Kreyl/Locket_hw/Locket v5 BOM.xlsx

Reference | Value | Quantity | Case | PN example | Comment | URL example
B1 | BAT_HOLDER | 1 |  | provide ourselves
BLN1 | BALUN868JOHANSON | 1 |  | provide ourselves
BZ1 | PS-9627 | 1 |  | provide ourselves
C11 C12 | 18pF | 2 | 0603 | CC0603GPNPO9BN180 | any 18 pF capacitor (np0 isolator, 0603 EIA case size) no less then 6.3V
C13 C14 C15 C16 C17 C18 C19 C2 C21 C3 C4 C7 | 0.1u | 12 | 0603 | CL10B104KA8NNND | any 0.1u capacitor (x5r or x7r isolator, 0603 EIA case size) no less then 6.3V
C23 | 3.3pF | 1 | 0603 | GRM0225C1E3R3BA03L | any 3.3pF capacitor (np0 isolator, 0402 EIa Case size)
C1 C10 C20 C22 C25 C8 C9 | 10u | 7 | 0603 | CL10A106MQ8NNNC | any 10u capacitor (x5r or x7r isolator, 0603 EIA case size) no less then 6.3V
C26 | 100pF | 1 | 0402 | GRM1555C1H101JA01D | any 100 pF capacitor (np0 isolator, 0402 EIA case size) no less then 6.3V
C5 | 10n | 1 | 0603 | GCM188R72A103KA37D | any 10n capacitor (x5r or x7r isolator, 0603 EIA case size) no less then 6.3V
C6 | 1u | 1 | 0603 | CC0603KRX5R6BB105 | any 1u capacitor (x5r or x7r isolator, 0603 EIA case size) no less then 6.3V
D1 D2 | BAT54WS | 2 | SOD323 | BAT54WS |  | https://detail.1688.com/offer/40898109343.html?spm=b26110380.sw1688.mof001.10.3ca27372cg8QKP
DA1 | NCP1400 | 1 | SOT23-5 | NCP1400ASN33T1G |  | https://detail.1688.com/offer/540300246216.html?spm=b26110380.sw1688.mof001.119.632d7b28plc2Xe https://item.taobao.com/item.htm?id=19334025583&ns=1&abbucket=17
DD1 | STM32L151CxTx | 1 | LQFP48 | stm32L151c8t6-A |  | https://detail.1688.com/offer/558836849740.html?spm=b26110380.sw1688.mof001.22.19377c45TD5jn9 https://detail.1688.com/offer/573325269319.html?spm=b26110380.sw1688.mof001.79.796628faiDYZyS
DD3 | CC1101 | 1 | QFN20 | CC1101rgpr |  | https://detail.1688.com/offer/548676031389.html?spm=b26110380.sw1688.mof001.24.fae05d3eP8B6Ai
L1 | 22uH | 1 | 1210 | LQH32CN220K23L | any 22uH 150mA (or more) no more then 3mm height | https://detail.1688.com/offer/528392533919.html?spm=b26110380.sw1688.mof001.165.e9171017nwvsnq
L2 L3 | BLM15AG102SN1 | 2 | 0402 | BLM15AG102SN1 |  | https://detail.1688.com/offer/528397777745.html?spm=b26110380.sw1688.mof001.394.3e0c4cffyidIBF
L4 | 8.2nH | 1 | 0402 | LQG15HS8N2J02D | 8.2nH inductor 0402 EIA case size | https://detail.1688.com/offer/561487499843.html?spm=b26110380.sw1688.mof001.150.23c5545d32EGdF
M1 | MOTOR_NO_CONTACTS | 1 |  | provide ourselves |  | http://www.aliexpress.com/item/100pcs-lot-Model-1227-Voltage-3V-Coin-Vibration-Micro-Motor-Flat-Toy-Cell-Phone-Pager/1435504466.html
Q1 | LED_RGB 5050 | 1 |  | provide ourselves
Q2 Q3 | MMBT2222 | 2 | SOT23-3 | MMBT2222ALT1G |  | https://detail.1688.com/offer/554838664791.html?spm=b26110380.sw1688.mof001.35.6fc14c4aL9JYax
R1 R2 R3 | 100R | 3 | 0603 | RC0603FR-07100RL | any resistor 100R 0603 EIA case size 1% tolerance
R10 R11 R4 R5 | 10k | 4 | 0603 | RC0603FR-0710KL | any resistor 10k 0603 EIA case size 1% tolerance
R12 R8 | 56k | 2 | 0603 | RC0603FR-0756KL | any resistor 56k 0603 EIA case size 1% tolerance
R13 R9 | 1k | 2 | 0603 | RC0603FR-071KL | any resistor 1k 0603 EIA case size 1% tolerance
R6 | 150R | 1 | 0603 | RC0603FR-07150RL | any resistor 150R 0603 EIA case size 1% tolerance
R7 | 100k | 1 | 0603 | RC0603FR-10100KL | any resistor 100k 0603 EIA case size 1% tolerance
SW1 | DIPx8 | 1 |  | provide ourselves
SW2 SW3 SW5 | BUTTON | 3 |  | provide ourselves
SW4 | SWITCH | 1 |  | provide ourselves |  | https://s.1688.com/collaboration/collaboration_search.htm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
XL1 | CONN_6 | 1 |  | provide ourselves
XL2 | CONN_4 | 1 |  | provide ourselves
XTAL1 | 27MHz | 1 | 0532 | CX3225SB27000H0FLJCC (https://www.digikey.com/product-detail/en/kyocera-international-inc-electronic-components/CX3225SB27000H0FLJCC/1253-1754-1-ND/6123381) | any 27MHz crystal 3.2mm x 2.5mm, tolerance 10ppm | https://detail.1688.com/offer/44836150823.html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
