Kreyl/Locket_hw/Locket v.5 final 08.10.2018 China with prices.xlsx

legend | Comment | Reference | Value | Footprint | Quantity | PN example | URL example | Price (rub) | SolderPointsDIP | SolderPoints | Total SP | Sum
we have | bought 200 pcs | B1 | BAT_HOLDER | Installation:BATTERY_AAA_X2 | 1 |  |  | 5 | 2 |  | 2 | 5
manufacture | bought 200 pcs | BLN1 | BALUN868JOHANSON | Radio:BALUN_JOHANSON868 | 1 | 0896BM15A0001E | https://www.digikey.com/product-detail/en/johanson-technology-inc/0896BM15A0001E/712-1474-1-ND/2038629 | 20 |  | 6 | 6 | 20
need to buy | bought 100 pcs | BZ1 | PS-9627 | Installation:BUZZER_HC0903 | 1 | PS-9627 | http://www.buzzer-china.com/product/Magnetic-Transducer(External-Drive-Type)-PS-9627_6191.html | 5 | 2 |  | 2 | 5
need to order | any 18 pF capacitor (np0 isolator, 0603 EIA case size) no less then 6.3V | C11 C12 | 18pF | Capacitors:CAP_0603 | 2 | CC0603GPNPO9BN180 |  | 1 |  | 2 | 4 | 2
 | any 0.1u capacitor (x5r or x7r isolator, 0603 EIA case size) no less then 6.3V | C13 C14 C15 C16 C17 C18 C19 C2 C21 C3 C4 C7 | 0.1u | Capacitors:CAP_0603 | 12 | CL10B104KA8NNND |  | 1 |  |  | 0 | 12
 | any 3.3pF capacitor (np0 isolator, 0402 EIa Case size) | C23 | 3.3pF | Capacitors:CAP_0402 | 1 | GRM0225C1E3R3BA03L |  | 1 |  | 2 | 2 | 1
 | any 10u capacitor (x5r or x7r isolator, 0603 EIA case size) no less then 6.3V | C1 C10 C20 C22 C25 C8 C9 | 10u | Capacitors:CAP_0603 | 7 | CL10A106MQ8NNNC |  | 3 |  | 2 | 14 | 21
 | any 100 pF capacitor (np0 isolator, 0402 EIA case size) no less then 6.3V | C26 | 100pF | Capacitors:CAP_0402 | 1 | GRM1555C1H101JA01D |  | 1 |  | 2 | 2 | 1
 | any 10n capacitor (x5r or x7r isolator, 0603 EIA case size) no less then 6.3V | C5 | 10n | Capacitors:CAP_0603 | 1 | GCM188R72A103KA37D |  | 1 |  | 2 | 2 | 1
 | any 1u capacitor (x5r or x7r isolator, 0603 EIA case size) no less then 6.3V | C6 | 1u | Capacitors:CAP_0603 | 1 | CC0603KRX5R6BB105 |  | 3 |  | 2 | 2 | 3
 | Diode Small Signal Schottky | D1 D2 | BAT54WS | Diodes:SOD323 | 2 | BAT54WS | https://detail.1688.com/offer/40898109343.html?spm=b26110380.sw1688.mof001.10.3ca27372cg8QKP | 2 |  | 2 | 4 | 4
 | micropower step−up DC to DC converter ncp1400A | DA1 | NCP1400 | SOT:SOT23-5 | 1 | NCP1400ASN33T1G | https://detail.1688.com/offer/540300246216.html?spm=b26110380.sw1688.mof001.119.632d7b28plc2Xe https://item.taobao.com/item.htm?id=19334025583&ns=1&abbucket=17 | 10 |  |  | 0 | 10
 | microcontroller STM32L151CxTx | DD1 | STM32L151CxTx | LQFP_TQFP:LQFP48 | 1 | stm32L151c8t6 | https://detail.1688.com/offer/537609578515.html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 https://item.taobao.com/item.htm?id=558738634814&ns=1&abbucket=17 |  |  | 48 | 48 | 0
 |  |  |  |  | 1 | stm32L151c8t6-A | https://detail.1688.com/offer/558836849740.html?spm=b26110380.sw1688.mof001.22.19377c45TD5jn9 https://detail.1688.com/offer/573325269319.html?spm=b26110380.sw1688.mof001.79.796628faiDYZyS | 120 |  |  |  | 120
 |  |  |  |  |  | stm32L151cBt6-A | https://detail.1688.com/offer/575765453492.html?spm=b26110380.sw1688.mof001.19.60466f3cpN7mwc |  |  |  |  | 0
 | accelerometer | DD2 | LIS3 | LGA:LGA16_3X3_5_3 | 1 | LIS3DH | https://detail.1688.com/offer/572603039060.html?spm=b26110380.sw1688.mof001.11.6b60718f5k1w5v | 17 |  |  | 0 | 17
 | radio | DD3 | CC1101 | QFN_DFN:QFN20 | 1 | CC1101rgpr | https://detail.1688.com/offer/548676031389.html?spm=b26110380.sw1688.mof001.24.fae05d3eP8B6Ai | 60 |  | 21 | 21 | 60
 | any 22uH 150mA (or more) no more then 3mm height | L1 | 22uH | Inductors:IND_1210_LQH32C | 1 | LQH32CN220K23L | https://detail.1688.com/offer/528392533919.html?spm=b26110380.sw1688.mof001.165.e9171017nwvsnq | 5 |  |  | 0 | 5
 |  | L2 L3 | BLM15AG102SN1 | Inductors:IND_0402 | 2 | BLM15AG102SN1 | https://detail.1688.com/offer/528397777745.html?spm=b26110380.sw1688.mof001.394.3e0c4cffyidIBF | 0.3 |  |  | 0 | 0.6
 | 8.2nH inductor 0402 EIA case size | L4 | 8.2nH | Inductors:IND_0402 | 1 | LQG15HS8N2J02D | https://detail.1688.com/offer/561487499843.html?spm=b26110380.sw1688.mof001.150.23c5545d32EGdF | 0.3 |  | 2 | 2 | 0.3
 | bought 100 pcs | M1 | MOTOR_NO_CONTACTS | Installation:Motor_no_Contacts | 1 | - | http://www.aliexpress.com/item/100pcs-lot-Model-1227-Voltage-3V-Coin-Vibration-Micro-Motor-Flat-Toy-Cell-Phone-Pager/1435504466.html | 5 |  | 0 | 0 | 5
 | bought 1000 pcs | Q1 | LED_RGB 5050 | LEDs:LED_5050 | 1 | - |  | 2 |  |  | 0 | 2
 |  | Q2 Q3 | MMBT2222 | SOT:SOT23-3 | 2 | MMBT2222ALT1G | https://detail.1688.com/offer/554838664791.html?spm=b26110380.sw1688.mof001.35.6fc14c4aL9JYax | 1 |  | 3 | 6 | 2
 | any resistor 100R 0603 EIA case size 1% tolerance | R1 R2 R3 | 100R | Resistors:RES_0603 | 3 | RC0603FR-07100RL |  | 0.8 |  | 2 | 6 | 2.4
 | any resistor 10k 0603 EIA case size 1% tolerance | R10 R11 R4 R5 | 10k | Resistors:RES_0603 | 4 | RC0603FR-0710KL |  | 0.8 |  |  | 0 | 3.2
 | any resistor 56k 0603 EIA case size 1% tolerance | R12 R8 | 56k | Resistors:RES_0603 | 2 | RC0603FR-0756KL |  | 0.8 |  | 2 | 4 | 1.6
 | any resistor 1k 0603 EIA case size 1% tolerance | R13 R9 | 1k | Resistors:RES_0603 | 2 | RC0603FR-071KL |  | 0.8 |  | 2 | 4 | 1.6
 | any resistor 150R 0603 EIA case size 1% tolerance | R6 | 150R | Resistors:RES_0603 | 1 | RC0603FR-07150RL |  | 0.8 |  | 2 | 2 | 0.8
 | any resistor 100k 0603 EIA case size 1% tolerance | R7 | 100k | Resistors:RES_0603 | 1 | RC0603FR-10100KL |  | 0.8 |  | 2 | 2 | 0.8
 | bought 50 pcs, mau be need to buy 50 more | SW1 | DIPx8 | BtnsSwitches:DIP_SMD_X8 | 1 | - |  | 50 |  | 16 | 16 | 50
 | bought 200 pcs, may be need to buy more | SW2 SW3 SW5 | BUTTON | BtnsSwitches:BTN_IT1198 | 3 | - |  | 2 |  |  | 0 | 6
 | need to buy | SW4 | SWITCH | BtnsSwitches:SW_SS-1P2T_Housing | 1 | SS-1p2T | https://s.1688.com/collaboration/collaboration_search.htm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 | 1 |  |  | 0 | 1
 | need to buy | XL1 | CONN_6 | Connectors:PLS-6 | 1 | - |  | 4 | 6 |  | 6 | 4
 | need to buy | XL2 | CONN_4 | Connectors:PBS-4R | 1 | PBS-4R (DS1024-1*4R2 China PN) |  | 8 | 4 | 0 | 4 | 8
 | need to buy, need to write about concrete model any resonator 27MHZ 3.2mm x 2.5 mm size, 10 (at least 20) ppm tolerance | XTAL1 | 27MHz | Quartz:03225C4 | 1 | CX3225SB27000H0FLJCC (https://www.digikey.com/product-detail/en/kyocera-international-inc-electronic-components/CX3225SB27000H0FLJCC/1253-1754-1-ND/6123381) | https://detail.1688.com/offer/44836150823.html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 | 4 |  | 4 | 4 | 4
 |  | PCB (из рассчета 100 шт) |  |  |  |  |  |  |  |  |  | 80
 |  |  |  |  |  |  |  |  |  |  |  | 460.3
