Kreyl/Locket_hw/Case/LocketTopStar.STL

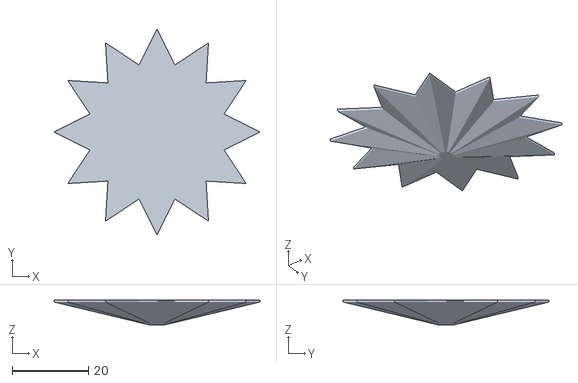
[picture p1: CAD file, 2016-01-13]
Case/LocketTopStar.STL
54.0 x 54.0 x 6.50
