Kreyl/Locket_hw/PCB/LocketEdgeCuts.DXF

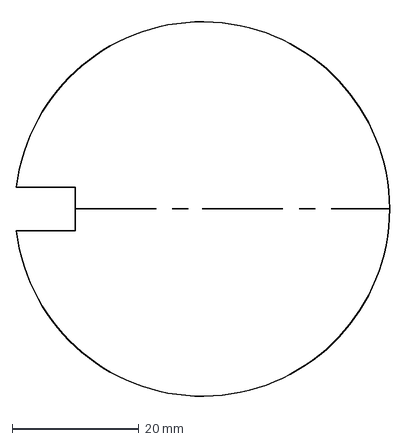
[picture p2: CAD file, 2016-01-20]
PCB/LocketEdgeCuts.DXF
58.8 x 60.7 mm
