Kreyl/Locket_hw/Case/LocketCase02.STL

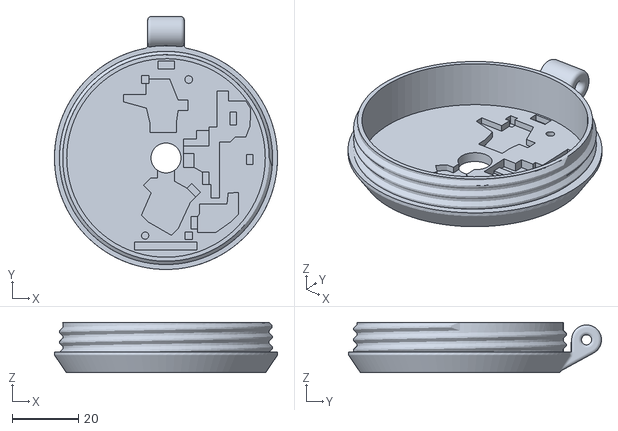
[picture p3: CAD file, 2016-01-13]
Case/LocketCase02.STL
67.2 x 76.2 x 15.2
