Kreyl/Locket_hw/Case/LocketCover.STL

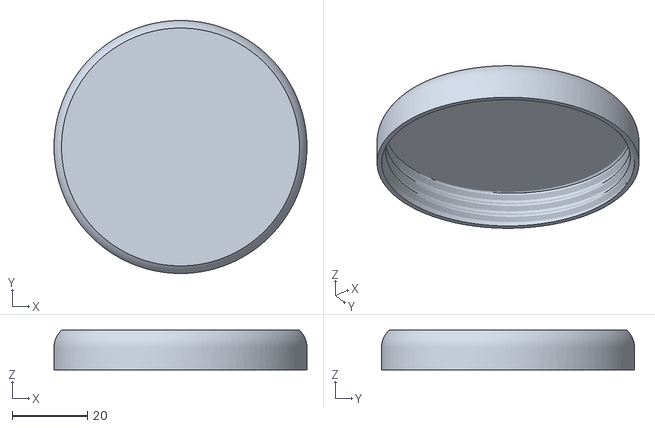
[picture p4: CAD file, 2016-01-13]
Case/LocketCover.STL
67.1 x 67.1 x 10.5
