Kreyl/Locket_hw/BottomComponents.pdf

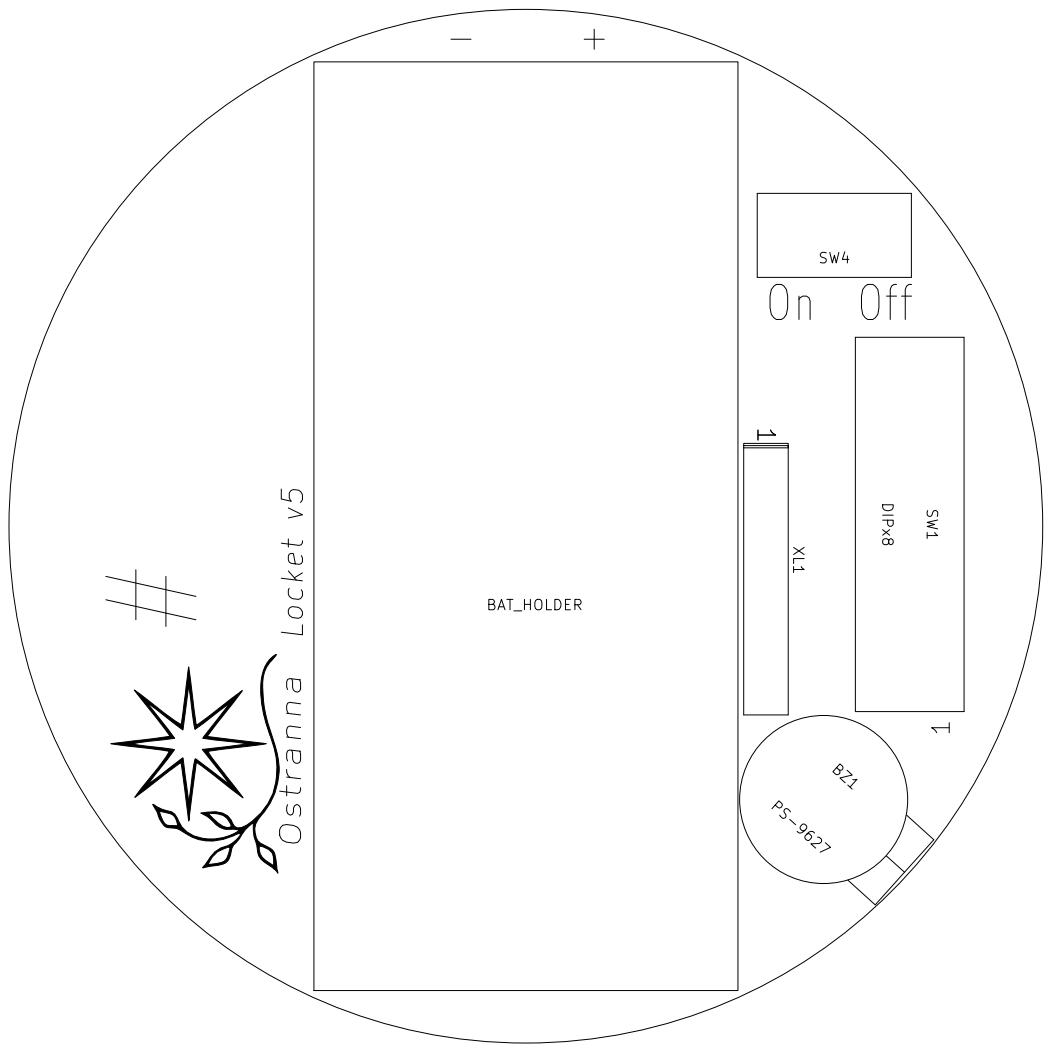
[picture p5: page 1]
