Kreyl/Locket_hw/TopComponents.pdf

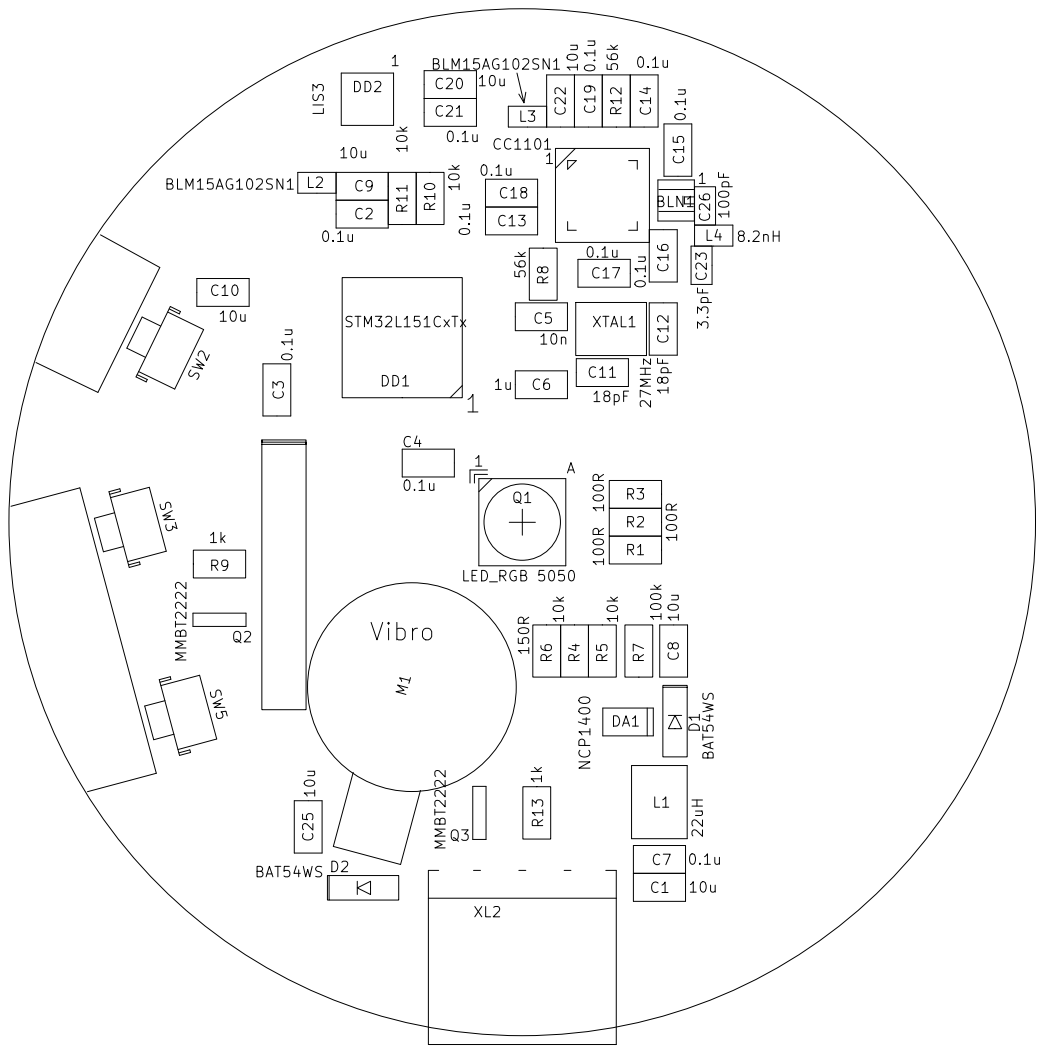
[picture p6: page 1]
