Kreyl/Locket_hw/PCB/LocketSch.pdf

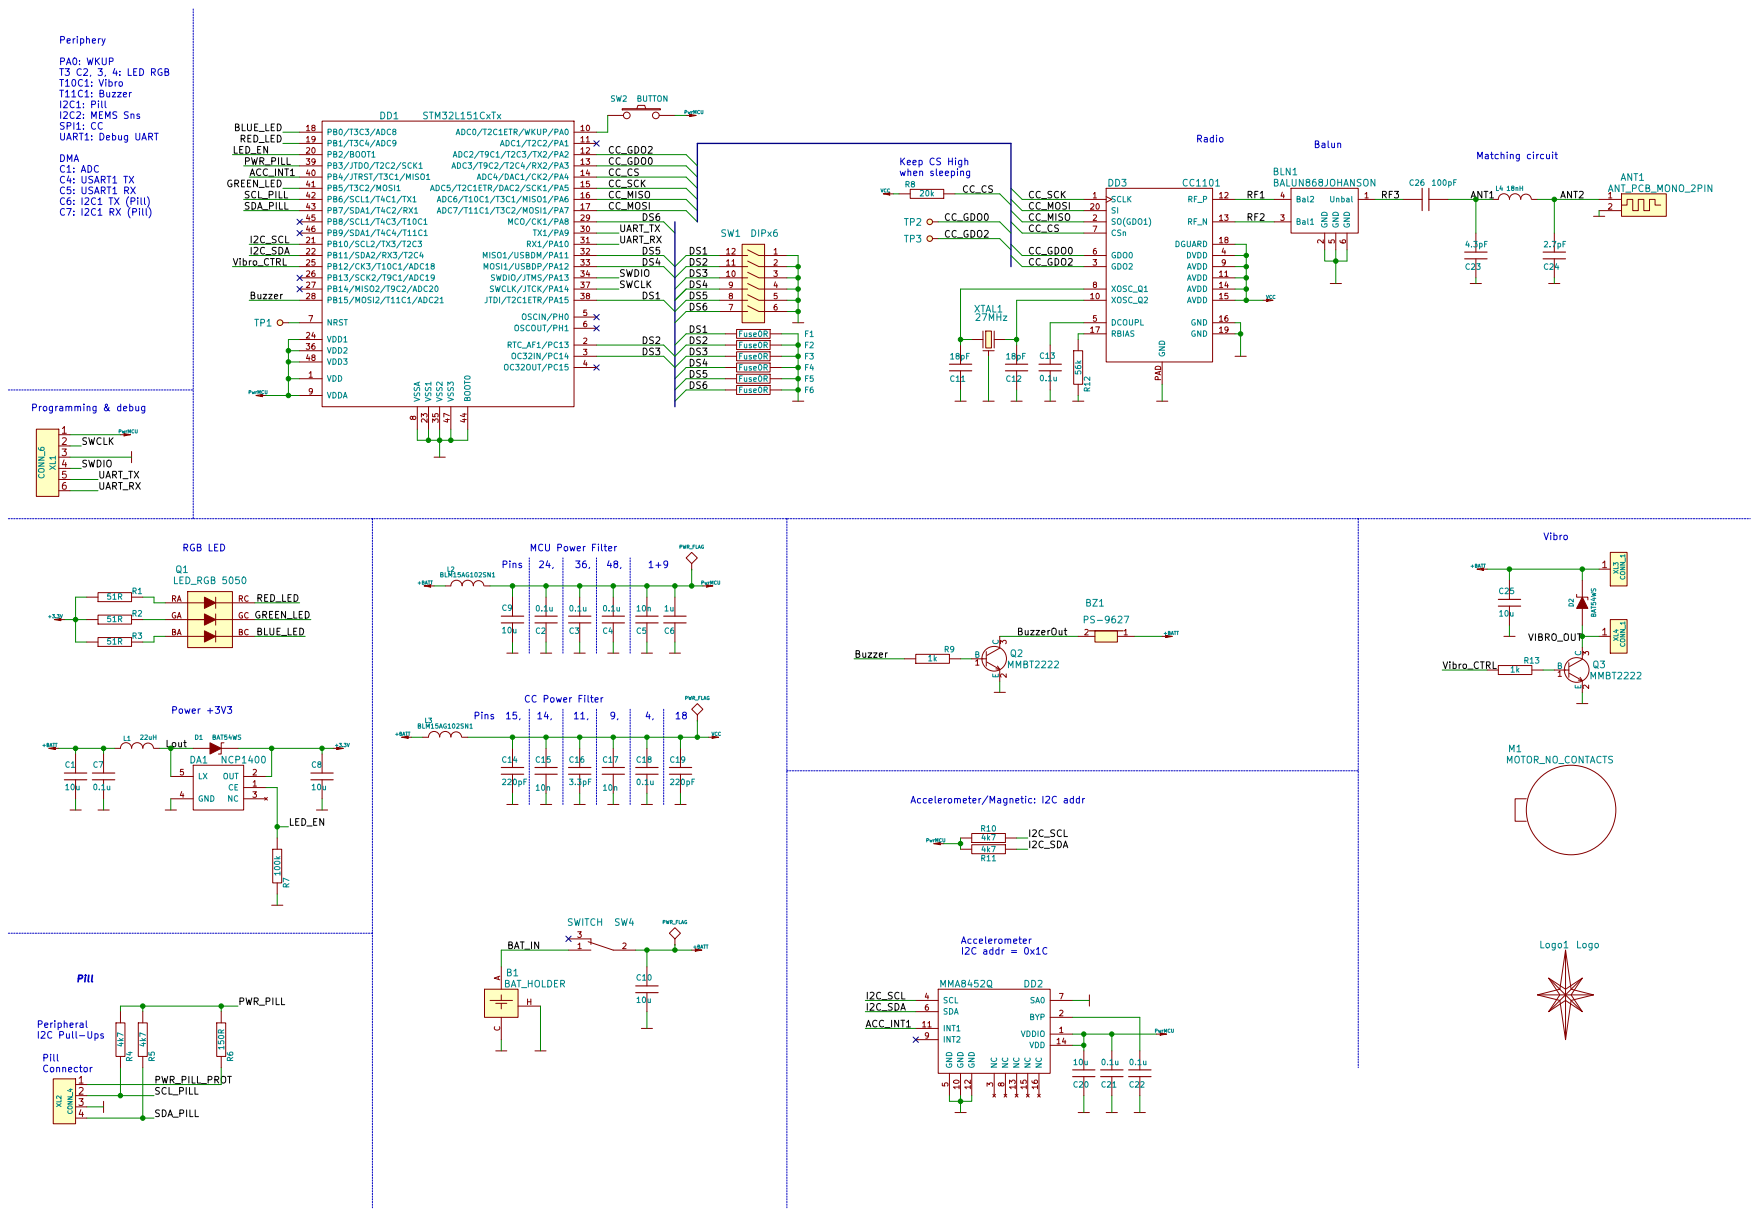
[picture p7: page 1]
