Kreyl/Locket_hw/LFSimulation/ir2.CIR

[Main]
FileType=CIR
Version=9.00
Program=Micro-Cap
Screen=1920,1080
MCAPVersion=9.0.6.1
Key ID=2 233 293 684
NLCnt=28
TXCnt=4

[shapedef]
Name=Battery
Line=0,0,22,0
Line=22,-3,22,3
Line=26,-7,26,7
Line=26,0,48,0
Current=32,8,16,8

[shapedef]
Name=Pulse_Source
Root="Vsource.root",0,-12,0
Line=20,-4,20,0
Line=20,0,26,0
Line=26,0,26,4

[shapedef]
Name=Resistor
PolyOpen=12 
PolyLine=0,0
PolyLine=0,0
PolyLine=12,0
PolyLine=14,-4
PolyLine=18,4
PolyLine=22,-4
PolyLine=26,4
PolyLine=30,-4
PolyLine=34,4
PolyLine=36,0
PolyLine=48,0
PolyLine=48,0
Current=32,8,16,8

[shapedef]
Name=NPN
Root="Bjt.root",0,-24,0
PolyClosed=3 ,Solid
PolyLine=20,12
PolyLine=24,12
PolyLine=24,8

[shapedef]
Name=Ground
Line=0,0,12,0
Line=12,-8,12,8
Line=18,-4,18,4
Line=24,0,24,0

[shapedef]
Name=Vsource.root
Line=0,0,12,0
Line=36,0,48,0
Ellipse=12,-12,36,12
Line=7,5,7,9
Root="Plus.root",39,5,0
Current=32,16,16,16

[shapedef]
Name=Plus.root
Line=-2,0,2,0
Line=0,-2,0,2

[shapedef]
Name=Bjt.root
Line=0,0,13,0
Rectangle=13,-12,15,12,SOLID
Current=32,-24,32,-16
Current=32,24,32,16
Current=0,-8,8,-8
PolyOpen=3 
PolyLine=24,-24
PolyLine=24,-12
PolyLine=14,-2
PolyOpen=3 
PolyLine=24,24
PolyLine=24,12
PolyLine=14,2

[compdef]
Name=Ground
Definition=Ground
Shape=Ground
Mask=1793
memo=Ground
Label Offset=0,0,0,0
PinCnt=1
Pin="PinA",0,0,-3,-7

[compdef]
Name=Battery
Definition=Battery
Shape=Battery
Mask=4865
memo=Battery
Label Offset=19,7,10,13
PinCnt=2
Pin="Plus",6,0,-4,-5
Pin="Minus",0,0,-10,-5

[compdef]
Name=Resistor
Definition=Resistor
Shape=Resistor
Mask=6657
memo=Resistor
Label Offset=18,6,8,11
PinCnt=2
Pin="Plus",6,0,-10,-4
Pin="Minus",0,0,-14,-4

[compdef]
Name=Pulse Source
Definition=Pulse source
Shape=Pulse_Source
Mask=4865
memo=Pulse Source
Label Offset=18,13,15,9
PinCnt=2
Pin="Plus",6,0,-5,-4
Pin="Minus",0,0,-19,-4

[compdef]
Name=MMBT2222A
Definition=NPN
Shape=NPN
Mask=4224
memo=NPN Switching Transistor 40V .6A .25W
Label Offset=29,-11,-6,26
PinCnt=3
Pin="Collector",3,-3,5,3
Pin="Base",0,0,-19,-3
Pin="Emitter",3,3,6,4
Power=0.25

[compdef]
Name=BC848C
Definition=NPN
Shape=NPN
Mask=4224
memo=NPN General Purpose Transistor 30V .1A .25W
Label Offset=29,-11,-6,26
PinCnt=3
Pin="Collector",3,-3,5,3
Pin="Base",0,0,-19,-3
Pin="Emitter",3,3,6,4
Power=0.25

[Circuit]
Window Placement=2,3, -1,-1, -8,-31, 104,104,1433,745
Default Object=Color=#000080
Default Object Font=Height=-15,FStyle=0,Color=#000080,Name=Arial
Default Object Apply Border To Text=No
Default Object Apply Fill To Text=No
WinBackGround Color=#FFFFFF
Select Color=#FF0000
Select Box Color=#000080
Grid Text Color=Height=-12,FStyle=0,Color=#0000FF,Name=Verdana
Component Color=#0000FF
Attribute Text=Height=-12,FStyle=0,Color=#008000,Name=Verdana
Wire Color=#008000
Bus Color=#008000
Pin Connection=Height=-10,FStyle=0,Color=#FF0000,Name=Arial
Node Number=Height=-11,FStyle=0,Color=#FF00FF,Name=Arial
Node Voltage Color=#000000
Dynamic AC Voltage Color=#E4E4E4
Text Banner Text=Height=-15,FStyle=0,Color=#800000,Name=Arial
Title Block Background=#C0C0C0
Current=Height=-11,FStyle=0,Color=#0000FF,Name=Arial
Power/Condition=Height=-11,FStyle=0,Color=#FF0000,Name=Arial
Digital Path Color=#FF0000
Title Block=Height=-15,FStyle=0,Color=#000000,Name=Arial
Disabled	Color=#C0C0C0
KeyWord Color=#0000FF
Error	Color=#FF0000
Digital 0 Color=#000000
Digital R Color=#FFFF00
Digital F Color=#FFFF00
Digital 1 Color=#FF0000
Digital X Color=#C0C0C0
Digital Z Color=#808080
Window Placement in Transient Analysis=0,1, -1,-1, -8,-31, 953,0,1906,878
SpiceType=AMBIGUOUS
Block Select Color=#51F998
TitleBlock Field_1=$name
TitleBlock Field_2=$user $company
TitleBlock Field_3
TitleBlock Field_4=$date
TitleBlock Field_5=Page $page of $maxpage
TitleBlock One Title=False
Title_Block_Border=False
Title_Block=False
Show Nodes=False
Show Voltages=False
Show Current=False
Show Power=False
Show Condition=False
Show Pin Connections=False
Show Cross=False
Show Attribute Text=True
Show Grid Text=True

[Comp]
Name=Ground
Grid=46,82
Rot=7

[Comp]
Name=Ground
Grid=15,70
Rot=7

[Comp]
Name=Battery
Grid=7,38
Rot=3

[Attr]
ONV=-26,-27,PART,V1
Style=8192

[Attr]
ONV=-38,-41,VALUE,2.8

[Comp]
Name=Ground
Grid=7,38
Rot=7

[Wire]
Grids=7,27,7,32

[Wire]
Grids=7,27,8,27

[Wire]
Grids=15,61,15,63

[Comp]
Name=Resistor
Grid=46,47
Rot=5

[Attr]
ONV=8,-25,PART,R1
Style=8192

[Attr]
ONV=8,-39,RESISTANCE,1
Style=8192

[Wire]
Grids=46,34,46,41

[Wire]
Grids=39,62,43,62

[Comp]
Name=Resistor
Grid=15,55
Rot=7

[Attr]
ONV=-26,15,PART,R2
Style=8192

[Attr]
ONV=9,6,RESISTANCE,10k
Style=8192

[Comp]
Name=Resistor
Grid=46,82
Rot=5

[Attr]
ONV=8,-25,PART,R3
Style=8192

[Attr]
ONV=7,-39,RESISTANCE,0
Style=8192

[Wire]
Grids=46,65,46,76

[Comp]
Name=Pulse Source
Grid=15,70
Rot=3

[Attr]
ONV=-31,-23,PART,V2
Style=8192

[Attr]
ONV=-66,-37,MODEL,PULSE

[Wire]
Grids=15,63,15,64

[Wire]
Grids=46,47,46,49

[Comp]
Name=MMBT2222A
Grid=43,62

[Attr]
ONV=29,-11,PART,Q1
Style=8192

[Attr]
ONV=29,3,MODEL,MMBT2222A

[Attr]
ONV=29,17,POWER,0.25

[Attr]
ONV=29,45,PACKAGE,SOT-23

[Wire]
Grids=15,55,22,55

[Wire]
Grids=25,38,25,49

[Wire]
Grids=25,62,39,62

[Wire]
Grids=25,58,25,62

[Comp]
Name=Ground
Grid=25,81
Rot=7

[Comp]
Name=Resistor
Grid=25,81
Rot=5

[Attr]
ONV=8,-25,PART,R4
Style=8192

[Attr]
ONV=11,-37,RESISTANCE,1k
Style=8192

[Wire]
Grids=25,62,25,75

[Comp]
Name=BC848C
Grid=22,55

[Attr]
ONV=29,-11,PART,Q2
Style=8192

[Attr]
ONV=29,3,MODEL,BC848C

[Attr]
ONV=29,17,POWER,0.25

[Attr]
ONV=29,45,PACKAGE,SOT-23

[Wire]
Grids=25,49,46,49

[Wire]
Grids=25,49,25,52

[Wire]
Grids=46,49,46,59

[Grid Text]
Text="Vbat"
Grid=8,27
CBorder=NONE

[Grid Text]
Text="Vbat"
Grid=46,34
CBorder=NONE

[Grid Text]
Text="Ub"
Grid=39,62
CBorder=NONE

[Grid Text]
Text="Uin"
Grid=15,63
CBorder=NONE

[Schematic]
CurrentSection 0=0
CurrentSection 1=0
CurrentSection 2=0
CurrentSection 3=0
Splitter.xs=0
Splitter.ys=0
TextQuad=4099
Scale=1
PrinterScale=1
GridUser=10
ShapeGroups="Main","Euro","DeMorgan","Polarity","Electrolytic"
CalcRMS=False
CalcAVG=False
CalcPeak=False
DisplayMeasure=Last

[Tools]
Pos=Top
PROBE=Yes
SELECT=Yes
COMP=Yes
TEXT=Yes
WIRE=Yes
WIRED=Yes
BUS=Yes
GRAPHIC=Yes
LINE=No
ELLIPSE=No
RECT=No
DIAM=No
ARC=No
PIE=No
LEFTBRK=No
RIGHTBRK=No
BOTHBRK=No
FLAG=Yes
META=No
INFO=Yes
HELP=Yes
LINK=Yes
REGION_ENABLE=Yes
DIGTRC=No
DIGTRC2=No
DIGALL=No
GRIDTEXT=Yes
COMPTEXT=Yes
NODE=Yes
MEASURED=Yes
NODEV=Yes
CURRENT=Yes
POWER=Yes
CONDITIN=Yes
PIN=Yes
CROSS=No
GRID=Yes
BORDER=No
TITLE=Yes
RUBBER=Yes
PROPERTY=Yes
STEP=Yes
MIRROR=Yes
ROTATE=Yes
FLIPY=Yes
FLIPX=Yes
FINDCOMP=Yes
FIND=Yes
REPEAT=No
MODEL=Yes
CIR2CKT=No
ATTDISP=No
ENABLE=Yes
DISABLE=Yes
TOFRONT=Yes
TOBACK=Yes
SELNEXT=No
PAGEADD=No
PAGEDEL=No
ZOOMIN=Yes
ZOOMOUT=Yes
GOTOFLAG=No
UPLEVEL=Yes
COLOR=Yes
FONT=Yes

[Section]
Index=0
Name="ir2"
Type=Main
Enable=True
CurrentPage 0=0
CurrentPage 1=0
CurrentPage 2=0
CurrentPage 3=0
TabSize 0=425
TabSize 1=425
TabSize 2=425
TabSize 3=425

[Page]
Index=0
Section=0
Print=True
Enable=True
Name=Main
Scale 0=1
Scale 1=1
Scale 2=1
Scale 3=1
Grid=35,49

[Page]
Index=1
Section=0
Type=Text
Print=False
Enable=True
Name=Text

[Page]
Index=2
Section=0
Type=Text
Print=False
Enable=True
Name=Models
SB 0=54,5

[Page]
Index=3
Section=0
Type=Info
Print=False
Enable=True
Name=Info

[Text Area]
Section=0
Page=1
Font=Height=-15,FStyle=0,Color=#000000,Name=Courier New
Comment Color=#008000
Background Color=#FFFFFF
Len=0


[Text Area]
Section=0
Page=2
Font=Height=-15,FStyle=0,Color=#000000,Name=Courier New
Comment Color=#008000
Background Color=#FFFFFF
Len=630
*** From file C:\MC9\library\UTILITY.LBR
*** 5V Square Wave
.MODEL SQUARE PUL (P1=0 P2=1n P3=8u P4=9u VONE=100m)
*** From file C:\MC9\library\UTILITY.LBR
*** 5V Pulse Source
.MODEL PULSE PUL (P1=0 P2=0 P3=8u P4=8u P5=17u VONE=2)
*** From file C:\MC9\library\MPBJT.LBR
*** NPN 1.5A 80V
.MODEL BD139 NPN (BF=200 BR=99.671345772217m CJC=5p CJE=2p
+ IKF=559.818760296133m IKR=999.999675660315m IS=9.999956070726f
+ ISC=404.194992780472f ISE=972.249942004551f ITF=10m MJC=500m MJE=500m
+ NC=2.000000001175 NE=1.562677837831 NF=1.001625491959 RC=309.205194321893m
+ RE=365.688938169078m TF=1n TR=10n VAF=100 VTF=10 XTF=500m)

[Transient]
Window Placement=0,1, -1,-1, -8,-31, 0,0,953,878
Font=Height=-15,FStyle=0,Color=#0000FF,Name=Arial
WinBackGround Color=#FFFFFF
Select Color=#FF0000
Select Box Color=#000080
Title
AutoTitle=Yes
Grid Color=#808080
Grid Weight=1
Grid Pattern=Dot6
Tracker Foreground=Height=-15,FStyle=0,Color=#000000,Name=Arial
Tracker Background=#FFFF00
Baseline color=#0000FF
Static Grids=False
PlusMark=False
MinorLog25=Off
LabelMinor=Off
OperPoint=True
OperPointOnly=False
AutoScaleRanges=False
DataPoints=False
Token=False
Ruler=False
XAxisGrids=True
YAxisGrids=True
MinorLogGrids=True
BaseLine=False
Graph Background=#FFFFFF
Tracker Intercept=False
Tracker Mouse=True
Tracker Cursor=True
Tracker Cursor BranchInfo=False
Horizontal Cursor=False
Same Y Scales=Yes
Enable X Scaling=True
Enable Y Scaling=False
Keep X Scales The Same=False
Number of Grids X=5
Number of Grids Y=5
Cursor Select Color Primary=#C0C0C0
Cursor Select Color Secondary=#FF0000
Data Point Labels Color Fore=Height=-15,FStyle=0,Color=#000000,Name=Arial
Data Point Labels Color Back=#FFFF00
FFT_NPts="1024"
FFT_IncludeDCHarmonic=False
FFT_AutoScale_Harmonics="10"
PrinterAutoTile=No
PrinterBlackBorder=No
MonMaxShow=4
MonPageWidth=66
MonPlotWidth=21
MonExprXWidth=142
MonExprYWidth=260
MonRangeXWidth=90
MonRangeYWidth=90
AnimateWait=0
AnimateWaitTime=500
Save_For_Future=No
Reduce_Display=1
Reduce_Save=1
Num Out Header Left
Num Out Header Center="$MC\n$user\n$company\n$Analysis of $name"
Num Out Header Right
Num Out Delimiter=32
Num Out Write=True
Num Out Write Main Header=True
Num Out Write Limits=True
Num Out Write Branch Header=True
Num Out Write Models=True
Num Out Write Zero Models=True
Num Out Write Undefined Models=True
Num Out Write Operating Point=True
Num Out Write Values=True
Num Out Write Waveform Header=True
Num Out Low="TMIN"
Num Out High="TMAX"
Num Out Font=Height=-15,FStyle=0,Color=#000000,Name=Courier New

[Tools]
Pos=Top
SELECT=Yes
GRAPHIC=Yes
LINE=No
ELLIPSE=No
RECT=No
DIAM=No
ARC=No
PIE=No
LEFTBRK=No
RIGHTBRK=No
BOTHBRK=No
POLYCLOS=No
SCALE=Yes
CURSOR=Yes
MEASUREH=Yes
MEASUREV=Yes
TAG=Yes
PTAG=Yes
TEXT=Yes
PROPERTY=Yes
START=Yes
STOP=Yes
PAUSE=Yes
DATAPTS=Yes
TOKENS=Yes
RULER=Yes
PLUS=Yes
XAXIS=Yes
YAXIS=Yes
MINORLOG=Yes
LOG25=Yes
BASELINE=Yes
HORIZCUR=Yes
GOTOX=Yes
GOTOY=Yes
GOTOPERF=Yes
GOTOBRNC=Yes
CLEAR_ACCUMULATED=Yes
PDELETE_ALL_PLOTS=Yes
NEXT=Yes
NEXTIN=Yes
PEAK=Yes
VALLEY=Yes
HIGH=Yes
LOW=Yes
INFLECTN=Yes
GHIGH=Yes
GLOW=Yes
BOTTOM=Yes
TOP=Yes
WAVEFORMBUFFER=Yes
AOUTPUT=Yes
PKEY=Yes
ENXSCALE=Yes
ENYSCALE=Yes
ZOOMIN=Yes
ZOOMOUT=Yes
AUTOSCALE=Yes
COLOR=Yes
FONT=Yes
SELNEXT=No

[APage]
Analysis=Transient
Name="Main"

[Monte Carlo Options]
Analysis=Transient
Status=Off
Zero Tolerance=False
Distribution=Normal
Number of Runs=10
Seed=0

[Limits]
Analysis=Transient
TRange=50u
TStep=0
NPts=51
Temp=27
RetraceRuns=1
StateVar=Zero
RunOption=Normal
Temperature Type=Linear
Accumulate Plots=False

[WaveForm]
Analysis=Transient
Plt=1
AliasID=1
XExp=T
YExp=v(UB)
XRng=AutoAlways
YRng=1.5,0
Options=LINEARX,LINEARY
Range Grid Y=0.05
Line Color=#0000FF
Text Color=#0000FF
Rainbow=False
VFmtX=3
VFmtY=3
ScaleFactorX="None"
ScaleFactorY="None"
ScaleUnitsX="Auto"
ScaleUnitsY="Auto"
SFmtX=3
SFmtY=3

[WaveForm]
Analysis=Transient
AliasID=4
XExp=T
YExp=I(R2)
XRng=AutoAlways
YRng=AutoAlways
Options=LINEARX,LINEARY
Line Color=#8000E0
Text Color=#8000E0
Rainbow=False
VFmtX=3
VFmtY=3
ScaleFactorX="None"
ScaleFactorY="None"
ScaleUnitsX="Auto"
ScaleUnitsY="Auto"
SFmtX=3
SFmtY=3

[WaveForm]
Analysis=Transient
Plt=1
AliasID=2
XExp=T
YExp=I(R1)
XRng=AutoAlways
YRng=1.5,0
Options=LINEARX,LINEARY
Range Grid Y=0.05
Line Color=#FF0000
Text Color=#FF0000
Rainbow=False
VFmtX=3
VFmtY=3
ScaleFactorX="None"
ScaleFactorY="None"
ScaleUnitsX="Auto"
ScaleUnitsY="Auto"
SFmtX=3
SFmtY=3

[WaveForm]
Analysis=Transient
Plt=1
AliasID=3
XExp=T
YExp=V(UIN)
XRng=AutoAlways
YRng=1.5,0
Options=LINEARX,LINEARY
Range Grid Y=0.05
Line Color=#008000
Text Color=#008000
Rainbow=False
VFmtX=3
VFmtY=3
ScaleFactorX="None"
ScaleFactorY="None"
ScaleUnitsX="Auto"
ScaleUnitsY="Auto"
SFmtX=3
SFmtY=3

[Limits]
Analysis=DynamicAC
FirstValueDisplay=Mag
SecondValueDisplay=PhaseDeg
PlaceText=True

[Limits]
Analysis=DynamicDC
PlaceText=True

[Pane]
Analysis=Transient
CurrentPage 0="Main"

[Pane]
Analysis=AC

[Pane]
Analysis=DC

[Pane]
Analysis=Distortion

[Watch]
Analysis=Transient
Format=3
ExprPercentWidth=80

[OPMethods]
Analysis=Transient
Standard Newton-Raphson=0,0
Source Stepping=0,0
Diagonal Gmin Stepping=0,0
Junction Gmin Stepping=0,0
Pseudo Transient=0,0

[OPMethods]
Analysis=AC
Standard Newton-Raphson=0,0
Source Stepping=0,0
Diagonal Gmin Stepping=0,0
Junction Gmin Stepping=0,0
Pseudo Transient=0,0

[OPMethods]
Analysis=DC
Standard Newton-Raphson=0,0
Source Stepping=0,0
Diagonal Gmin Stepping=0,0
Junction Gmin Stepping=0,0
Pseudo Transient=0,0
