Kreyl/Locket_hw/Locket.ioc

Mcu.UserName=STM32L151C8Tx
PA0-WKUP1.Signal=SYS_WKUP1
PA10.Signal=USART1_RX
PA11.Signal=GPIO_Input
PA12.Signal=GPIO_Input
PA13.Signal=SYS_JTMS-SWDIO
PA14.Signal=SYS_JTCK-SWCLK
PA15.Signal=GPIO_Input
PA2.Signal=GPIO_Input
PA3.Signal=GPIO_Input
PA4.Signal=GPIO_Output
PA5.Signal=SPI1_SCK
PA6.Signal=SPI1_MISO
PA7.Signal=SPI1_MOSI
PA8.Signal=GPIO_Input
PA9.Signal=USART1_TX
PB0.Signal=S_TIM3_CH3
PB1.Signal=S_TIM3_CH4
PB10.Signal=I2C2_SCL
PB11.Signal=I2C2_SDA
PB12.Signal=S_TIM10_CH1
PB15.Signal=S_TIM11_CH1
PB2.Signal=GPIO_Output
PB3.Signal=GPIO_Output
PB4.Signal=GPIO_Input
PB5.Signal=S_TIM3_CH2
PB6.Signal=I2C1_SCL
PB7.Signal=I2C1_SDA
PC13-WKUP2.Signal=GPIO_Input
PC14-OSC32_IN.Signal=GPIO_Input
