Kreyl/Locket_hw/(commit log)

2016-01-13 + HW1
    [Locket.kicad_pcb, Locket.sch, LocketCase02.STL, LocketCover.STL, LocketTopStar.STL]
2016-01-13 + HW3
    [Locket.sch]
2016-01-16 + lots of RF simulation + Components set up
    [Comparision.xlsx, Consumption.xlsx, Locket.kicad_pcb, Locket.sch]
2016-01-16 + Routing done
    [Locket.kicad_pcb, Locket.sch]
2016-01-20 * Locket3 finalized
    [Locket-B.Cu.gbl, Locket-B.Mask.gbs, Locket-B.SilkS.gbo, Locket-B_Cu.gbl, Locket-B_Mask.gbs, Locket-B_SilkS.gbo, Locket-Edge.Cuts.gm1, Locket-Edge_Cuts.gbr]
2016-02-07 * Antenna matched for open space
    [Locket-B.Cu.gbl, Locket-B.Mask.gbs, Locket-B.SilkS.gbo, Locket-Edge.Cuts.gm1, Locket-F.Cu.gtl, Locket-F.Mask.gts, Locket-F.SilkS.gto, Locket.drl]
2016-03-21 Started HW4
    [Locket.sch]
2016-04-30 + Stochastic antenna + Proceeding with PCB design
    [Locket.kicad_pcb, Locket.sch]
2016-05-01 Component placement done, but not good looking
    [Locket.kicad_pcb]
2016-05-07 Antenna completed, tracing started
    [Locket.kicad_pcb, Locket.sch]
2016-05-08 +Locket HW3 PCB done
    [Locket-B.Cu.gbl, Locket-B.Mask.gbs, Locket-B.SilkS.gbo, Locket-Edge.Cuts.gm1, Locket-F.Cu.gtl, Locket-F.Mask.gts, Locket-F.SilkS.gto, Locket.drl]
2016-05-08 Actually, it was HW4. * Motor moved a little.
    [Locket.kicad_pcb]
2016-07-28 + Locket 4.1, antenna matched
    [Locket.kicad_pcb, Locket.sch]
2016-08-29 * Buzzer info added
    [Locket.sch]
2018-09-15 Switch to newer KiCAD
    [Locket.csv, Locket.sch]
2018-10-03 Sent to test production
    [Locket.csv, Locket.kicad_pcb, Locket.sch]
2018-10-08 + Antenna matched * Silks changed according to new LEDs Heading to production
    [Locket v.5 final 08.10.2018 China with prices.xlsx, Locket v5 BOM.xlsx, Locket.kicad_pcb, Locket.sch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]
2019-03-28 Sch seems done
    [Locket.kicad_pcb, Locket.sch]
2019-03-29 PCB sent to factory
    [Locket.kicad_pcb, Locket.sch]
2019-05-03 + csv
    [Locket.csv]
